jasonacox/WeatherStationWiFi/kicad/WeatherStationWiFi.sch

## KiCad design kicad/WeatherStationWiFi.sch (2020-04-18)

Schematic: WeatherStationWiFi.sch

Parts:
BT1: 3.7V Li-ion Battery
C1: 220uF
C2: 0.1uF
C3: 100uF
D1: LED
E1-RainDetect: Water Electrode
PWR1: TP4056
Q1: 2N2222; TO-39-3
R1: 51K
R2: 100K
R3: 1K
R5: 440
SC1: 5V_Solar_Cell
U1: ESP8266 NodeMCU
U2: MCP1700-3302E_TO92; TO-92_Inline
U3: BME_BMP280; Bosch_LGA-8_2.5x2.5mm_P0.65mm_ClockwisePinNumbering
U4: A3144 (KY-003); SOT-23

Notes on the sheet:
GND
3.3V
0-5V
Voltage Sensor
A0 - Analog Input
Vin (from OUT+)
Vout
ESP8266
Voltage Divider Circuit
3.3v Voltage Regulator
