jasonacox/WeatherStationWiFi/secrets.h

/*
    Secrets - Set network SSID and password

    Solar Powered WiFi Weather Station
    ESP8266 NodeMCU Based Weather Station - Record Temperature (x2), Humidity, Pressure, Rain, and Voltage

    Send results to web or mqtt server
    
    Author: Jason A. Cox - @jasonacox - https://github.com/jasonacox/WeatherStationWiFi

    Date: 20 March 2020
    
*/
#define WIFISSID "SSID"
#define WIFIPASS "password"
