jasonacox/WeatherStationWiFi/(commit log)

2020-03-29 Added schematic
    [WeatherStationWiFi.sch]
2020-03-29 Updated kicad schematic
    [WeatherStationWiFi.sch]
2020-03-29 Update schematic with latest prototype
    [WeatherStationWiFi.sch]
2020-03-29 Updated schematic 3.3v highlight
2020-03-31 Added voltage divider breakout to schematic
    [WeatherStationWiFi.sch]
2020-03-31 List of Materials update and Voltage Graph
2020-04-18 Added Anemometer sensor for wind speed
    [WeatherStationWiFi.sch]
2020-04-18 Added 3D Printed Parts
    [WeatherStationWiFi.sch]
2020-04-25 Power saving and low-power mode changes
